Devenda/Cuby_Hardware/Assembly/Side.step

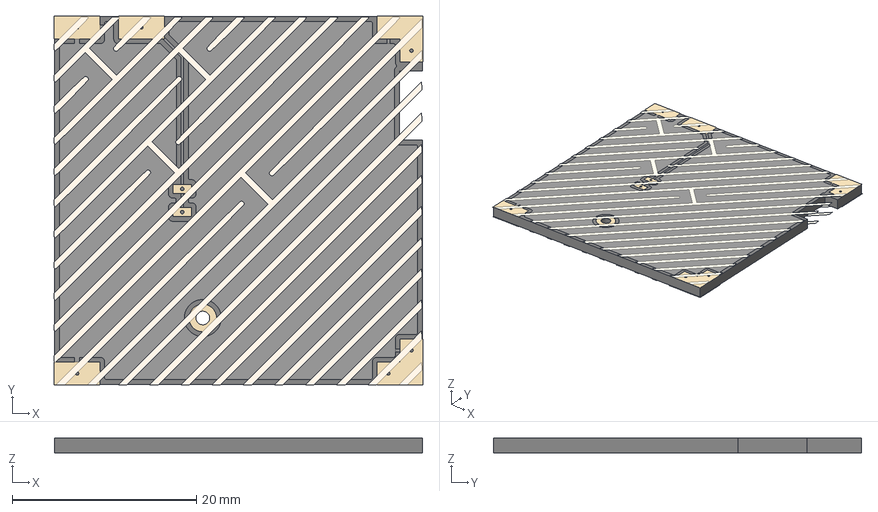
[picture p1: CAD file, 2019-10-11]
Assembly/Side.step
40.1 x 40.1 x 1.74 mm
Local_CS
PCB_Sketch
topTracks
botTracks
botSilks
topSilks
Step_Models
