Devenda/Cuby_Hardware/robot/Assembly/Top.step

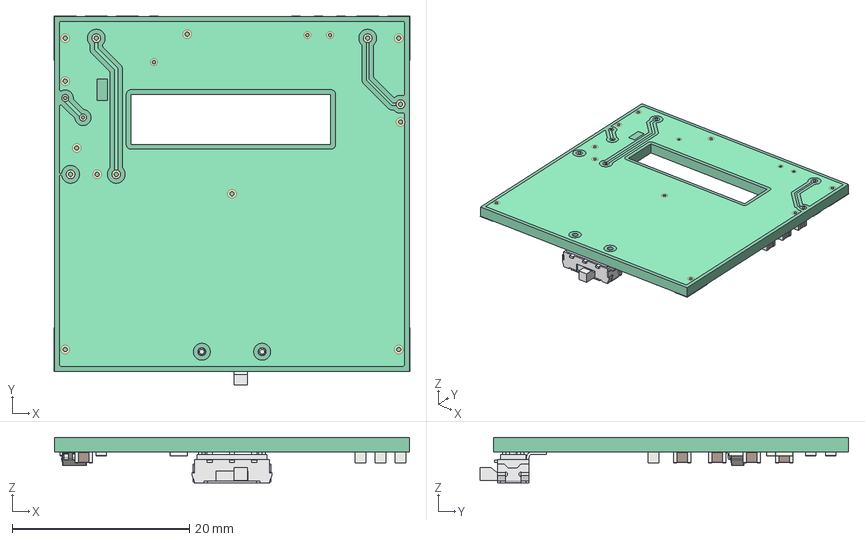
[picture p2: CAD file, 2019-10-03]
robot/Assembly/Top.step
40.1 x 41.6 x 5.15 mm
Local_CS
Pcb
PCB_Sketch
topTracks
botTracks
SW1_1_5D87707B
U2_SOT_23_5_5D8777B4
C2_C_0805_2012Metric_5D94FF89
C3_C_0805_2012Metric_5D94FF99
C4_C_0805_2012Metric_5D94FFA9
C5_C_0805_2012Metric_5D94FFB9
C6_C_0805_2012Metric_5D94FFC9
C7_C_0805_2012Metric_5D950188
R1_R_0805_2012Metric_5D94FFE9
R2_R_0805_2012Metric_5D94FFF9
R3_R_0805_2012Metric_5D950009
R4_R_0805_2012Metric_5D950019
R5_R_0805_2012Metric_5D950029
