Devenda/Cuby_Hardware/Assembly/Back.step

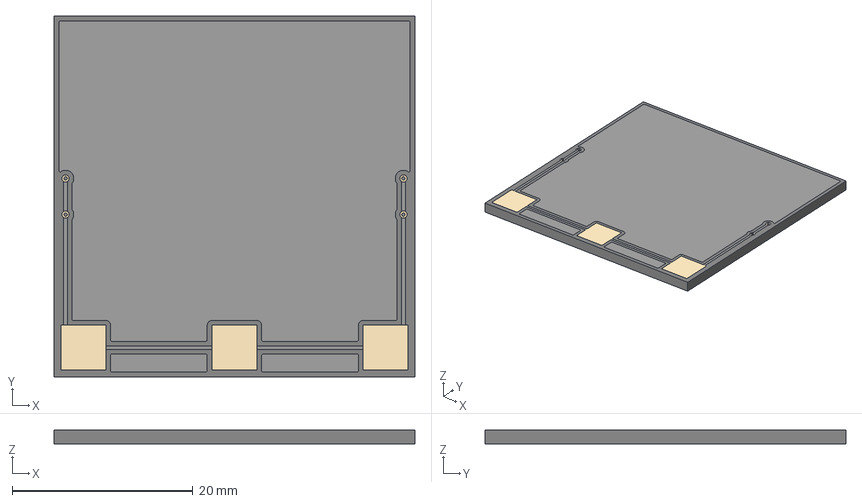
[picture p3: CAD file, 2019-10-11]
Assembly/Back.step
40.0 x 40.0 x 1.70 mm
Local_CS
Pcb
PCB_Sketch
topTracks
botTracks
Step_Models
