Devenda/Cuby_Hardware/(list of files, cad)

Other CAD files:
Back/Gerber/Back-B_SilkS.dxf
Back/Gerber/Back-F_SilkS.dxf
Bottom/Gerber/Bottom-B_SilkS.dxf
Bottom/Gerber/Bottom-F_SilkS.dxf
Front/Gerber/Front-B_SilkS.dxf
Front/Gerber/Front-F_SilkS.dxf
Top/Gerber/Top-B_SilkS.dxf
Top/Gerber/Top-F_SilkS.dxf
