Devenda/Cuby_Hardware/Bottom/Bottom.kicad_pcb

## KiCad design Bottom/Bottom.kicad_pcb (2019-12-20)

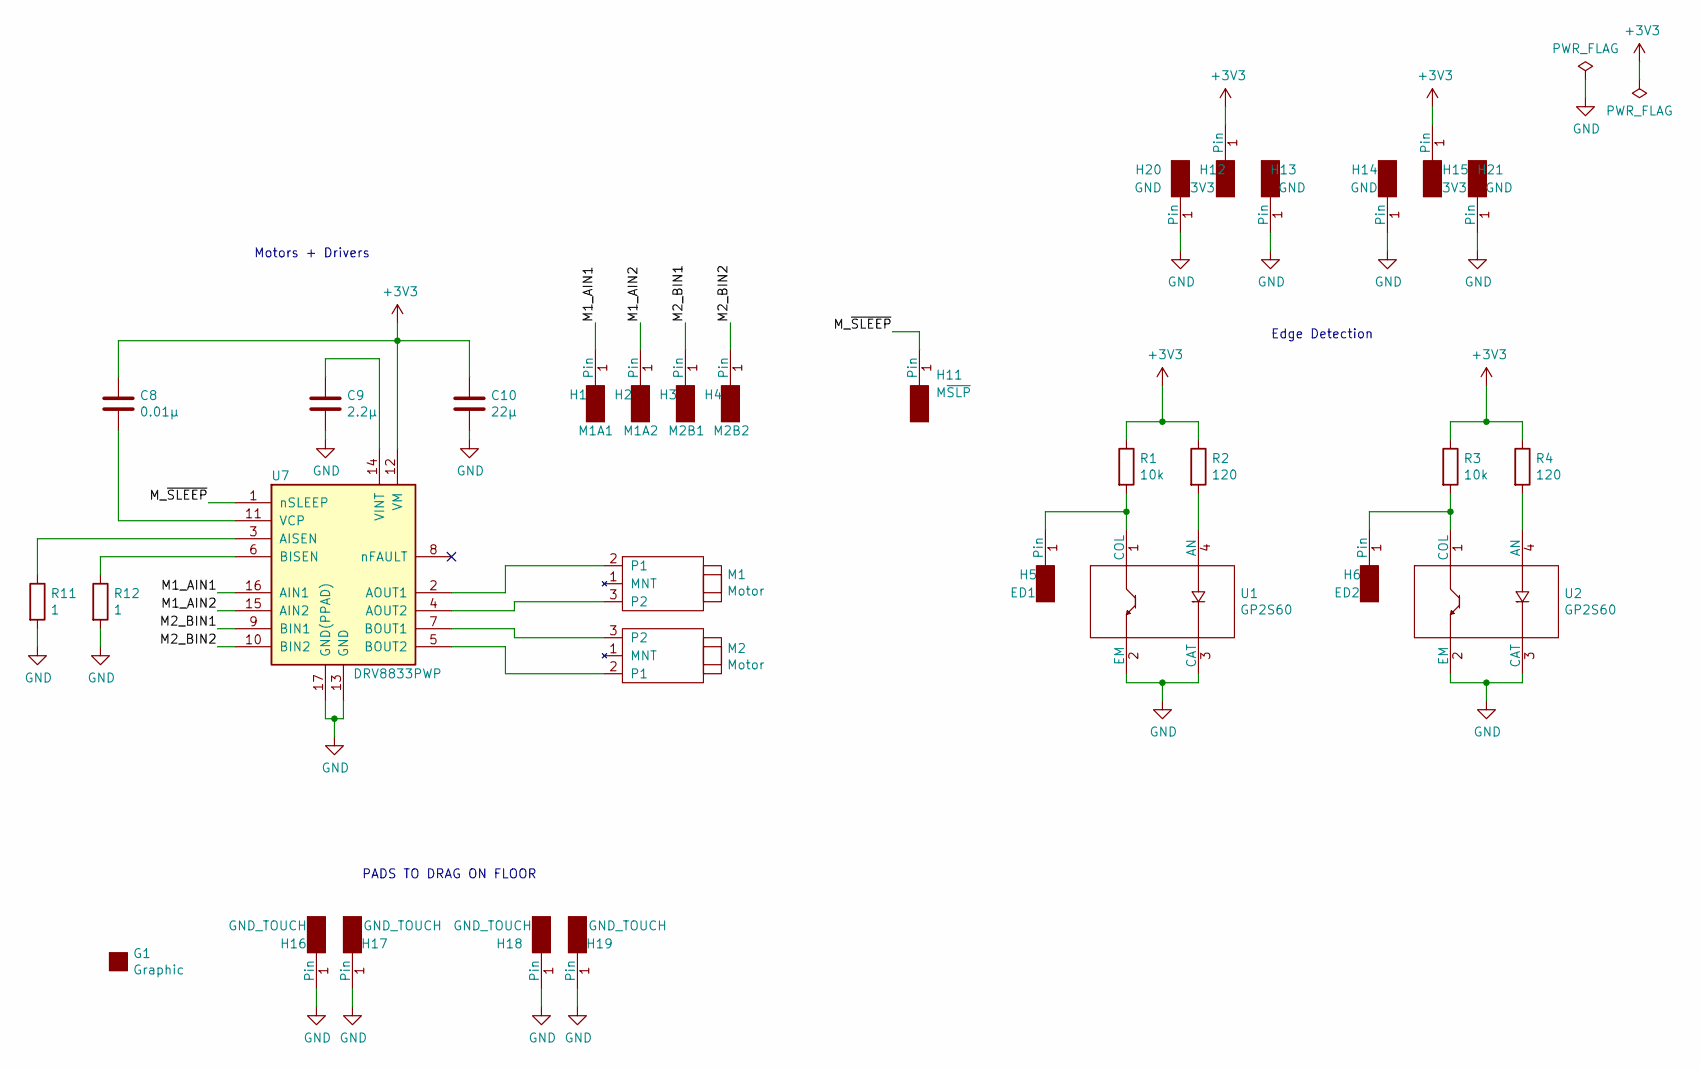
[picture p4: schematic Bottom.sch, Motor and Edge detection]

Parts:
C8: 0.01µ; C_0805_2012Metric; LCSC C52278
C9: 2.2µ; C_0805_2012Metric; LCSC C107171
C10: 22µ; C_0805_2012Metric; LCSC C5674
G1: Graphic; d2
H1: M1A1; Mounting_Pad_Signal
H2: M1A2; Mounting_Pad_Signal
H3: M2B1; Mounting_Pad_Signal
H4: M2B2; Mounting_Pad_Signal
H5: ED1; Mounting_Pad_Signal
H6: ED2; Mounting_Pad_Signal
H11: M~SLP; Mounting_Pad_Signal
H12, H15: 3V3; Mounting_Pad_Power
H13, H14, H20, H21: GND; Mounting_Pad_Power
H16, H17, H18, H19: GND_TOUCH; Mounting_Pad_Ground
M1, M2: Motor; Small_DC_Motor
R1, R3: 10k; R_0805_2012Metric; LCSC C38522
R2, R4: 120; R_0805_2012Metric; LCSC C25281
R11, R12: 1; R_0805_2012Metric; LCSC C25288
U1, U2: GP2S60; GP2S60_ReverseMount; LCSC C83485
U7: DRV8833PWP; HTSSOP-16-1EP_4.4x5mm_P0.65mm_EP3.4x5mm_Mask2.46x2.31mm_The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; Farnell 2057085RL

Connections:
+3V3: C8.1, C10.1, H12.1, H15.1, R1.1, R2.1, R3.1, R4.1, U7.12 (VM)
/M1_AIN1: H1.1, U7.16 (AIN1)
/M1_AIN2: H2.1, U7.15 (AIN2)
/M2_BIN1: H3.1, U7.9 (BIN1)
/M2_BIN2: H4.1, U7.10 (BIN2)
/M_~SLEEP: H11.1, U7.1 (nSLEEP)
GND: C9.2, C10.2, H13.1, H14.1, H16.1, H17.1, H18.1, H19.1, H20.1, H21.1, R11.2, R12.2, U1.2 (EM), U1.3 (CAT), U2.2 (EM), U2.3 (CAT), U7.13 (GND), U7.17 (GND(PPAD))
unnamed: C8.2, U7.11 (VCP)
unnamed: C9.1, U7.14 (VINT)
unnamed: H5.1, R1.2, U1.1 (COL)
unnamed: H6.1, R3.2, U2.1 (COL)
unnamed: M1.2 (P1), U7.2 (AOUT1)
unnamed: M1.3 (P2), U7.4 (AOUT2)
unnamed: M2.2 (P1), U7.5 (BOUT2)
unnamed: M2.3 (P2), U7.7 (BOUT1)
unnamed: R2.2, U1.4 (AN)
unnamed: R4.2, U2.4 (AN)
unnamed: R11.1, U7.3 (AISEN)
unnamed: R12.1, U7.6 (BISEN)

Notes on the sheet:
Motors + Drivers
Edge Detection
PADS TO DRAG ON FLOOR

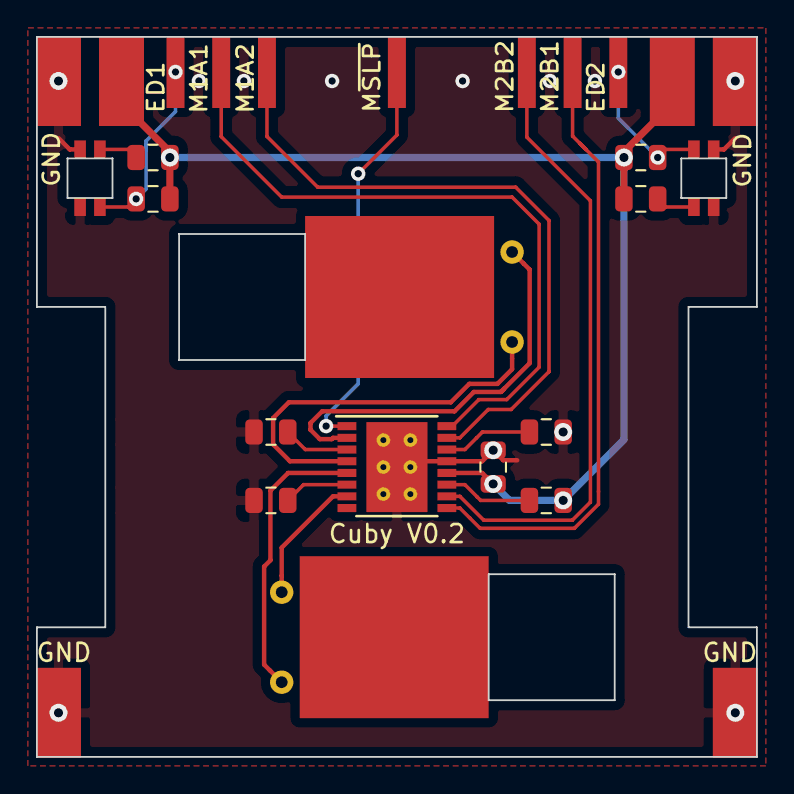
[picture p5: board Bottom.kicad_pcb from above]

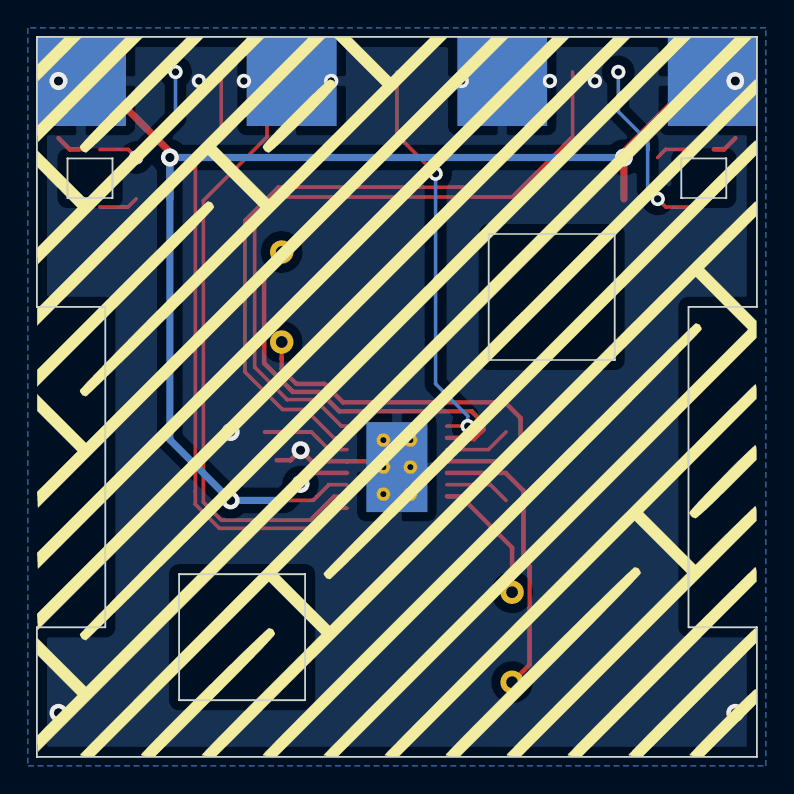
[picture p6: board Bottom.kicad_pcb from below]

Board: 2 copper layers, 40.0 x 40.0 mm, 32 parts (5 on the bottom side), 19 nets.
