Devenda/Cuby_Hardware/Front/Front.kicad_pcb

## KiCad design Front/Front.kicad_pcb (2019-12-20)

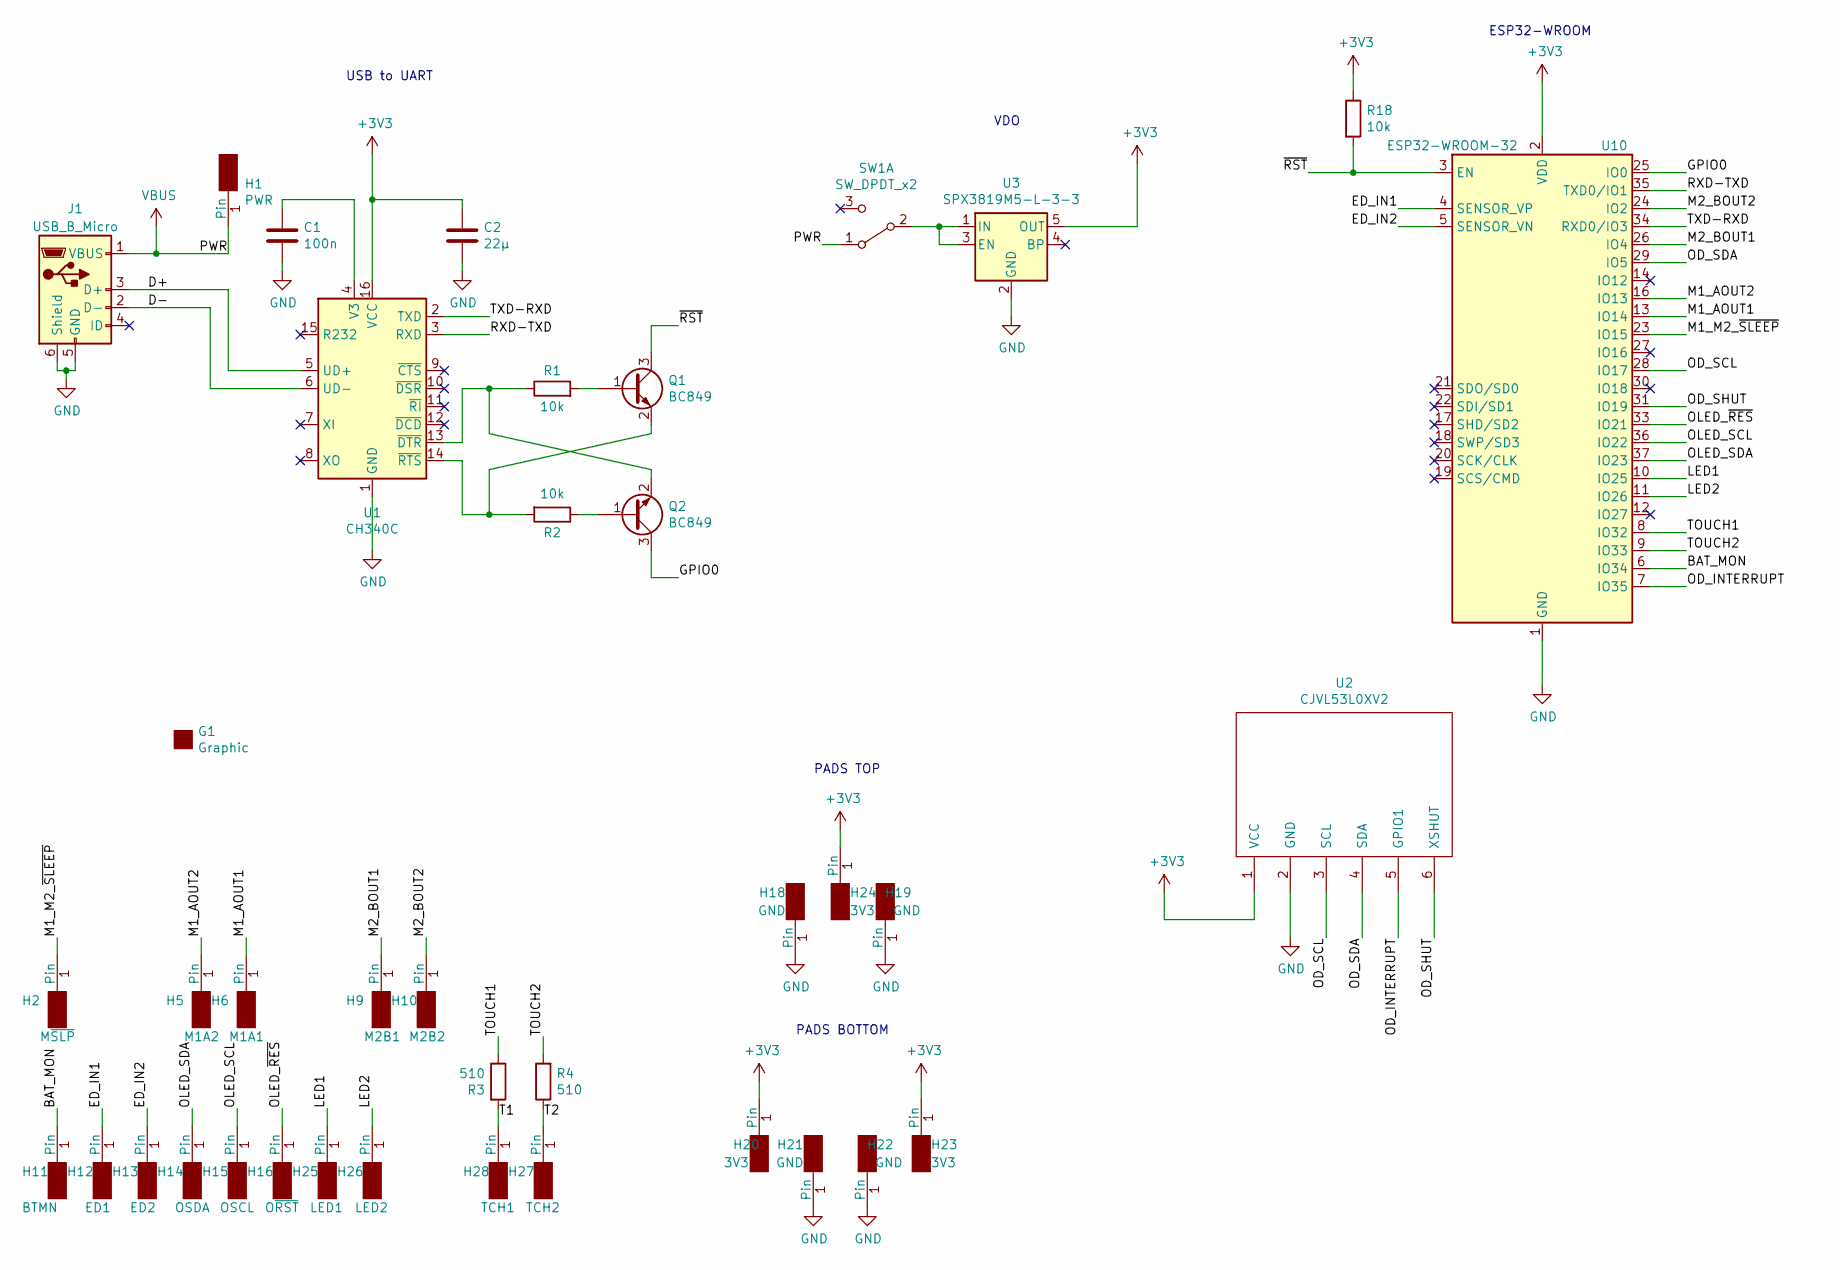
[picture p7: schematic Front.sch, Core]

Parts:
C1: 100n; C_0805_2012Metric; LCSC C282732
C2: 22µ; C_0805_2012Metric; LCSC C5674
G1: Graphic; d1
H1: PWR; Mounting_Pad_Power
H2: M~SLP; Mounting_Pad_Signal
H5: M1A2; Mounting_Pad_Signal
H6: M1A1; Mounting_Pad_Signal
H9: M2B1; Mounting_Pad_Signal
H10: M2B2; Mounting_Pad_Signal
H11: BTMN; Mounting_Pad_Signal
H12: ED1; Mounting_Pad_Signal
H13: ED2; Mounting_Pad_Signal
H14: OSDA; Mounting_Pad_Signal
H15: OSCL; Mounting_Pad_Signal
H16: O~RST; Mounting_Pad_Signal
H18, H19, H21, H22: GND; Mounting_Pad_Power
H20, H23, H24: 3V3; Mounting_Pad_Power
H25: LED1; Mounting_Pad_Signal
H26: LED2; Mounting_Pad_Signal
H27: TCH2; Mounting_Pad_Touch
H28: TCH1; Mounting_Pad_Touch
J1: USB_B_Micro; USB_Micro-B_Molex_47346-0001; LCSC C40942
Q1, Q2: BC849; SOT-23; LCSC C163753
R1, R2, R18: 10k; R_0805_2012Metric; LCSC C38522
R3, R4: 510; R_0805_2012Metric; LCSC C25283
SW1: SW_DPDT_x2; JS102011SAQN
U1: CH340C; SOIC-16_3.9x9.9mm_P1.27mm; LCSC C84681
U2: CJVL53L0XV2; GYVL53L0X_NoMountingHoles
U3: SPX3819M5-L-3-3; SOT-23-5; LCSC C9055
U10: ESP32-WROOM-32

Connections:
+3V3: C2.1, H20.1, H23.1, H24.1, R18.1, U1.16 (VCC), U2.1 (VCC), U3.5 (OUT), U10.2 (VDD)
/BAT_MON: H11.1, U10.6 (IO34)
/D+: J1.3 (D+), U1.5 (UD+)
/D-: J1.2 (D-), U1.6 (UD-)
/ED_IN1: H12.1, U10.4 (SENSOR_VP)
/ED_IN2: H13.1, U10.5 (SENSOR_VN)
/GPIO0: Q2.3 (C), U10.25 (IO0)
/LED1: H25.1, U10.10 (IO25)
/LED2: H26.1, U10.11 (IO26)
/M1_AOUT1: H6.1, U10.13 (IO14)
/M1_AOUT2: H5.1, U10.16 (IO13)
/M1_M2_~SLEEP: H2.1, U10.23 (IO15)
/M2_BOUT1: H9.1, U10.26 (IO4)
/M2_BOUT2: H10.1, U10.24 (IO2)
/OD_INTERRUPT: U2.5 (GPIO1), U10.7 (IO35)
/OD_SCL: U2.3 (SCL), U10.28 (IO17)
/OD_SDA: U2.4 (SDA), U10.29 (IO5)
/OD_SHUT: U2.6 (XSHUT), U10.31 (IO19)
/OLED_SCL: H15.1, U10.36 (IO22)
/OLED_SDA: H14.1, U10.37 (IO23)
/OLED_~RES: H16.1, U10.33 (IO21)
/RXD-TXD: U1.3 (RXD), U10.35 (TXD0/IO1)
/T1: H28.1, R3.2
/T2: H27.1, R4.1
/TOUCH1: R3.1, U10.8 (IO32)
/TOUCH2: R4.2, U10.9 (IO33)
/TXD-RXD: U1.2 (TXD), U10.34 (RXD0/IO3)
/~RST: Q1.3 (C), R18.2, U10.3 (EN)
GND: C1.2, C2.2, H18.1, H19.1, H21.1, H22.1, J1.5 (GND), J1.6 (Shield), U1.1 (GND), U2.2 (GND), U3.2 (GND), U10.1 (GND), U10.15 (GND), U10.38 (GND)
unnamed: C1.1, U1.4 (V3)
unnamed: Q1.1 (B), R1.2
unnamed: Q1.2 (E), R2.2, U1.14 (~RTS)
unnamed: Q2.1 (B), R2.1
unnamed: Q2.2 (E), R1.1, U1.13 (~DTR)
unnamed: SW1.2 (B), U3.1 (IN), U3.3 (EN)
VBUS: H1.1, J1.1 (VBUS), SW1.1 (A)

Notes on the sheet:
ESP32-WROOM
USB to UART
VDO
PADS BOTTOM
PADS TOP

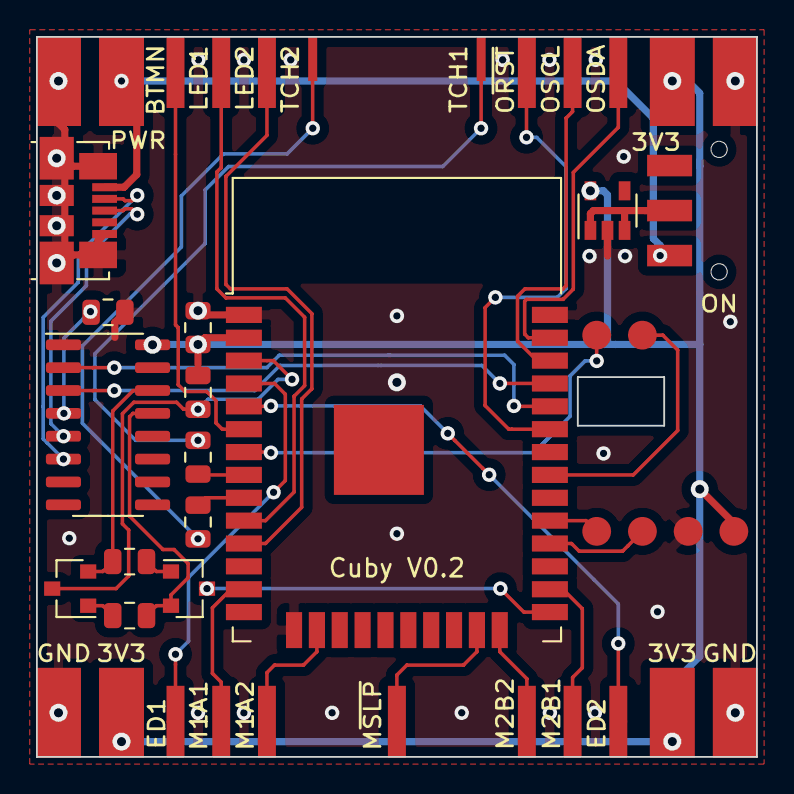
[picture p8: board Front.kicad_pcb from above]

Board: 2 copper layers, 40.0 x 40.0 mm, 39 parts (1 on the bottom side), 36 nets.
