Devenda/Cuby_Hardware/Top/Top.kicad_pcb

## KiCad design Top/Top.kicad_pcb (2019-12-04)

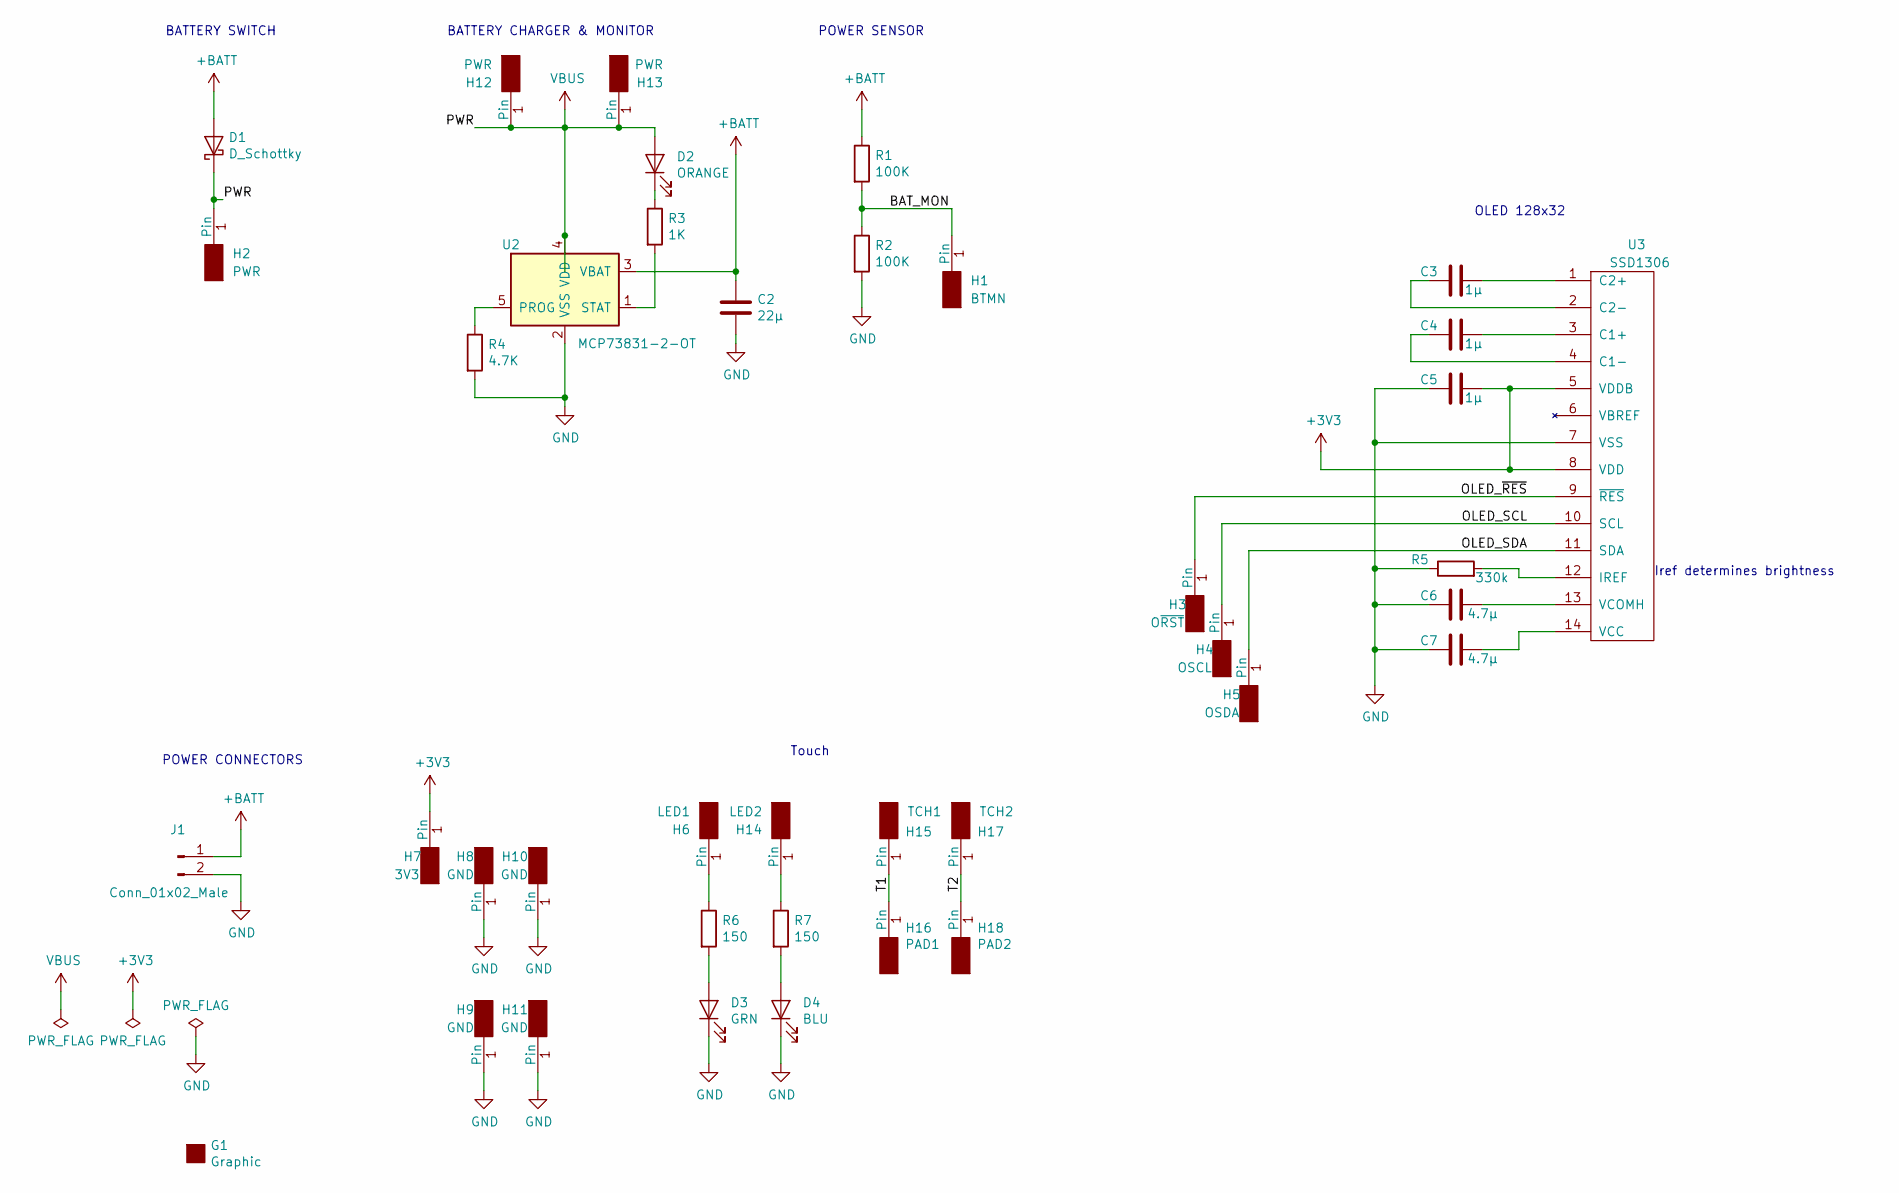
[picture p9: schematic Top.sch, (Top) Power Management + OLED]

Parts:
C2: 22µ; C_0805_2012Metric; LCSC C5674
C3, C4, C5: 1µ; C_0805_2012Metric; LCSC C106837
C6, C7: 4.7µ; C_0805_2012Metric; LCSC C87998
D1: D_Schottky; D_SOD-123; LCSC C181204
D2: ORANGE; LED_0805_2012Metric; LCSC C84269
D3: GRN; LED_0805_2012Metric
D4: BLU; LED_0805_2012Metric
G1: Graphic; d3
H1: BTMN; Mounting_Pad_Signal
H2, H12, H13: PWR; Mounting_Pad_Power
H3: O~RST; Mounting_Pad_Signal
H4: OSCL; Mounting_Pad_Signal
H5: OSDA; Mounting_Pad_Signal
H6: LED1; Mounting_Pad_Signal
H7: 3V3; Mounting_Pad_Power
H8, H9, H10, H11: GND; Mounting_Pad_Power
H14: LED2; Mounting_Pad_Signal
H15: TCH1; Mounting_Pad_Touch
H16: PAD1; Touch_Pad
H17: TCH2; Mounting_Pad_Touch
H18: PAD2; Touch_Pad
J1: Conn_01x02_Male; Conn_Bat
R1, R2: 100K; R_0805_2012Metric; LCSC C25611
R3: 1K; R_0805_2012Metric; LCSC C25623
R4: 4.7K; R_0805_2012Metric; LCSC C26022
R5: 330k; R_0805_2012Metric; LCSC C17629
R6, R7: 150; R_0805_2012Metric; LCSC C26022
U2: MCP73831-2-OT; SOT-23-5; LCSC C14879
U3: SSD1306; SSD1306_OLED

Connections:
+3V3: C5.1, H7.1, U3.5 (VDDB), U3.8 (VDD)
+BATT: C2.1, D1.2 (A), J1.1, R1.1, U2.3 (VBAT)
/BAT_MON: H1.1, R1.2, R2.1
/OLED_SCL: H4.1, U3.10 (SCL)
/OLED_SDA: H5.1, U3.11 (SDA)
/OLED_~RES: H3.1, U3.9 (~RES)
/T1: H15.1, H16.1
/T2: H17.1, H18.1
GND: C2.2, C5.2, C6.2, C7.1, D3.1 (K), D4.1 (K), H8.1, H9.1, H10.1, H11.1, J1.2, R2.2, R4.2, R5.1, U2.2 (VSS), U3.7 (VSS)
unnamed: C3.1, U3.1 (C2+)
unnamed: C3.2, U3.2 (C2-)
unnamed: C4.1, U3.3 (C1+)
unnamed: C4.2, U3.4 (C1-)
unnamed: C6.1, U3.13 (VCOMH)
unnamed: C7.2, U3.14 (VCC)
unnamed: D2.1 (K), R3.1
unnamed: D3.2 (A), R6.2
unnamed: D4.2 (A), R7.2
unnamed: H6.1, R6.1
unnamed: H14.1, R7.1
unnamed: R3.2, U2.1 (STAT)
unnamed: R4.1, U2.5 (PROG)
unnamed: R5.2, U3.12 (IREF)
VBUS: D1.1 (K), D2.2 (A), H2.1, H12.1, H13.1, U2.4 (VDD)

Notes on the sheet:
BATTERY CHARGER & MONITOR
POWER SENSOR
POWER CONNECTORS
OLED 128x32
Iref determines brightness
BATTERY SWITCH
Touch

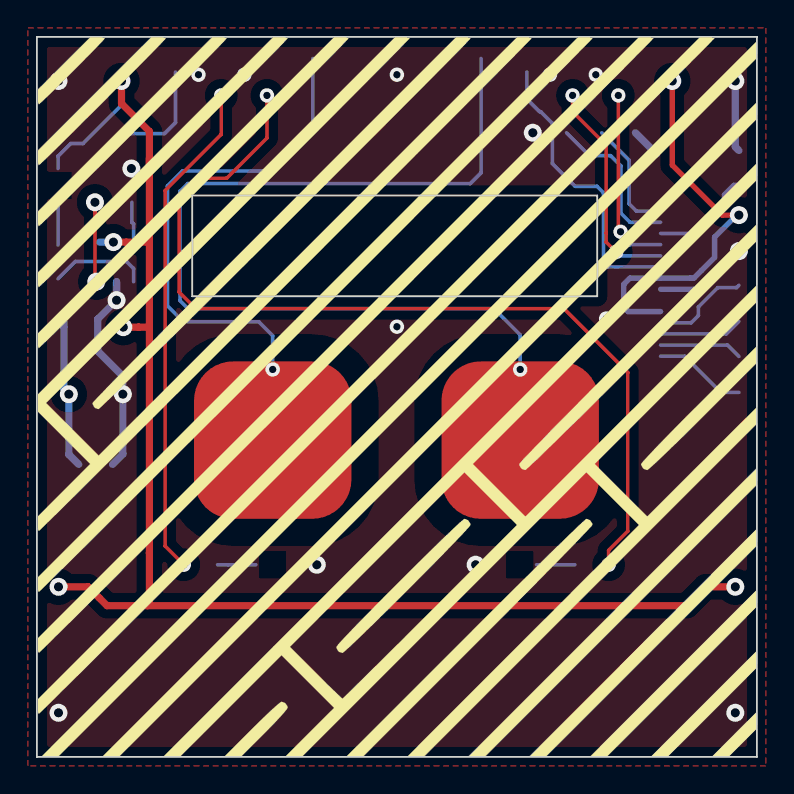
[picture p10: board Top.kicad_pcb from above]

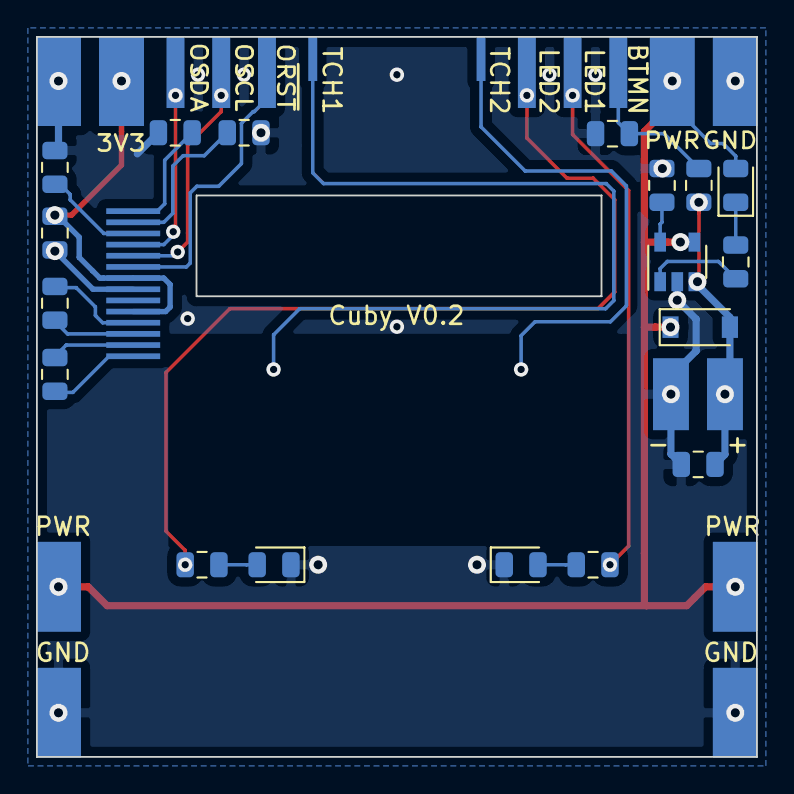
[picture p11: board Top.kicad_pcb from below]

Board: 2 copper layers, 40.0 x 40.0 mm, 39 parts (36 on the bottom side), 24 nets.
