Devenda/Cuby_Hardware/Side Left/SideLeft.kicad_pcb

## KiCad design Side Left/SideLeft.kicad_pcb (2019-10-11)

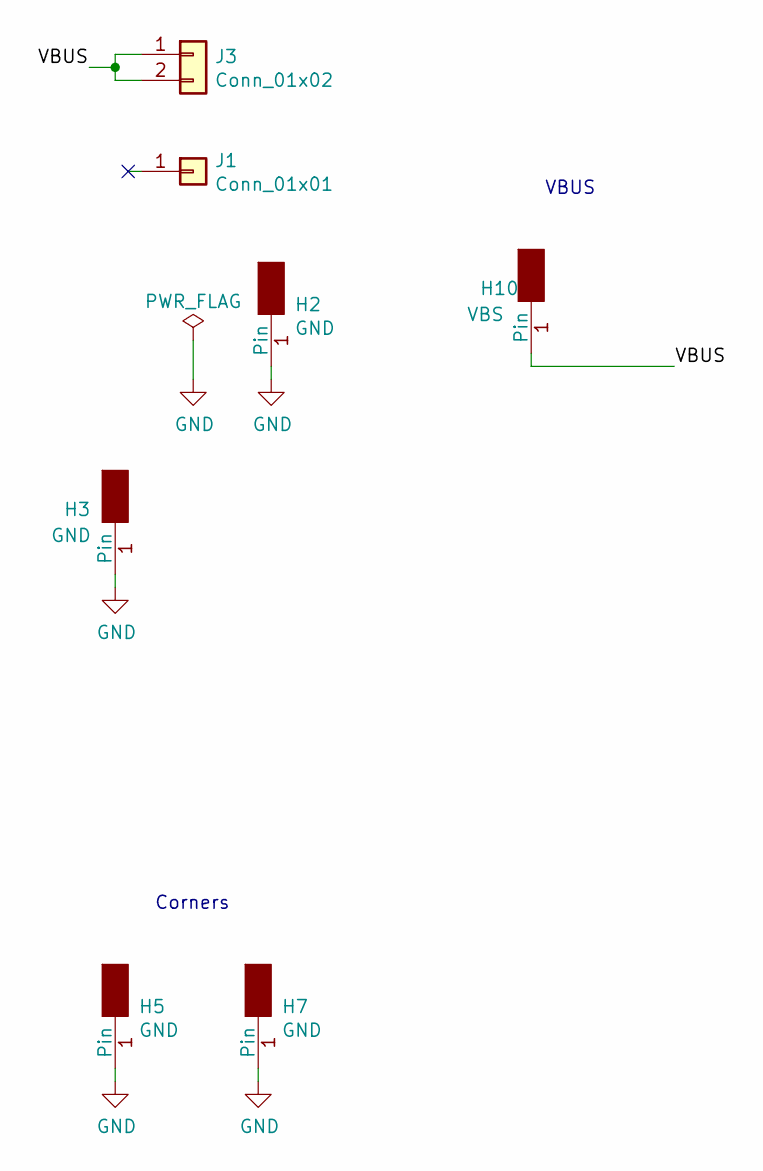
[picture p12: schematic SideLeft.sch, Side]

Parts:
H2, H3: GND; Mounting_Pad_Power
H5, H7: GND; Mounting_Pad_Power_Corner
H10: VBS; Mounting_Pad_Power
J1: Conn_01x01; Axis
J3: Conn_01x02; BG300-02-A-L-A

Connections:
/VBUS: H10.1, J3.1, J3.2
GND: H2.1, H3.1, H5.1, H7.1

Notes on the sheet:
Corners
VBUS

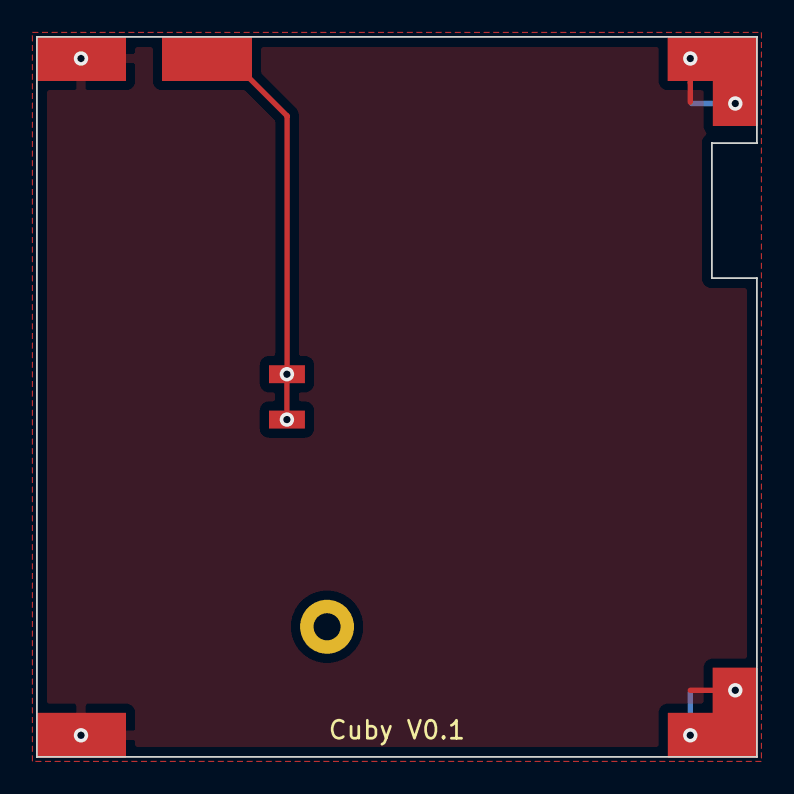
[picture p13: board SideLeft.kicad_pcb from above]

Board: 2 copper layers, 40.0 x 40.0 mm, 7 parts (0 on the bottom side), 2 nets.
