Devenda/Cuby_Hardware/Side Right/SideRight.kicad_pcb

## KiCad design Side Right/SideRight.kicad_pcb (2019-10-11)

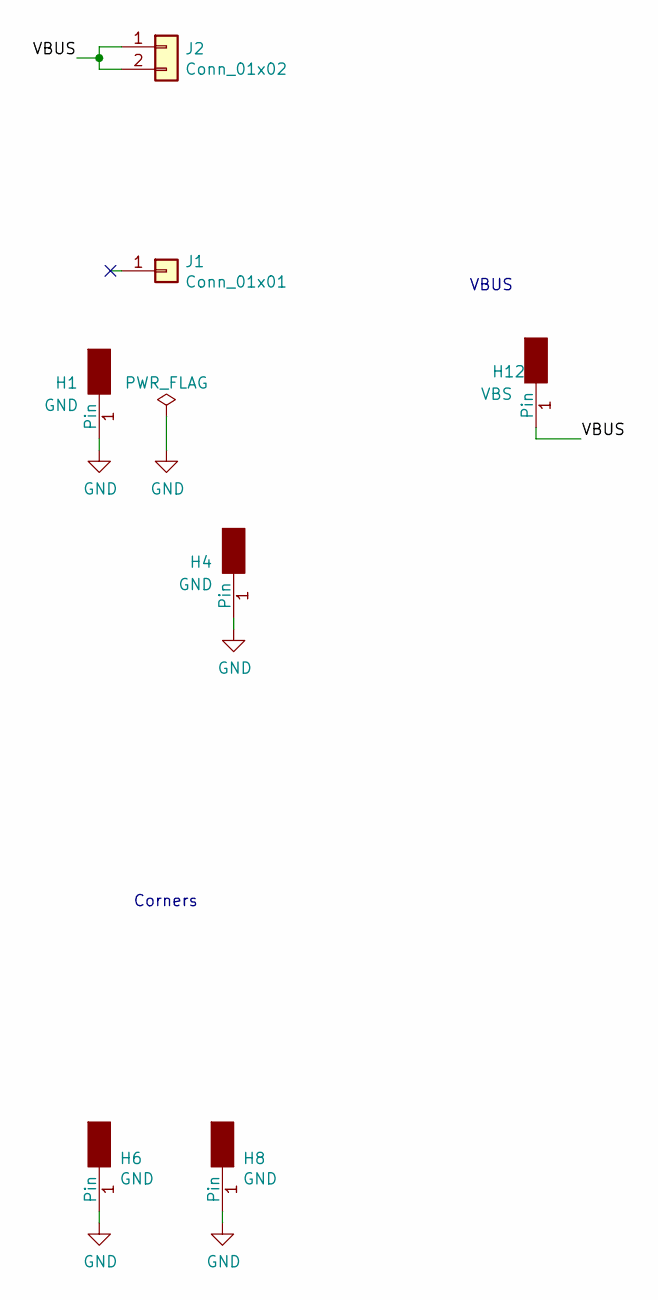
[picture p14: schematic SideRight.sch, Side]

Parts:
H1, H4: GND; Mounting_Pad_Power
H6, H8: GND; Mounting_Pad_Power_Corner
H12: VBS; Mounting_Pad_Power
J1: Conn_01x01; Axis
J2: Conn_01x02; BG300-02-A-L-A

Connections:
/VBUS: H12.1, J2.1, J2.2
GND: H1.1, H4.1, H6.1, H8.1

Notes on the sheet:
Corners
VBUS

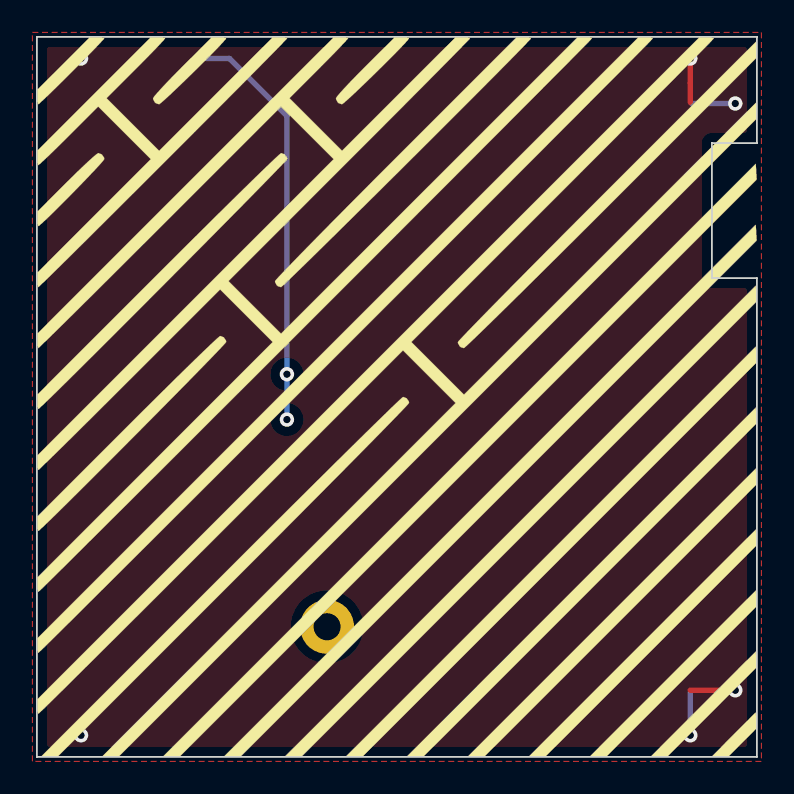
[picture p15: board SideRight.kicad_pcb from above]

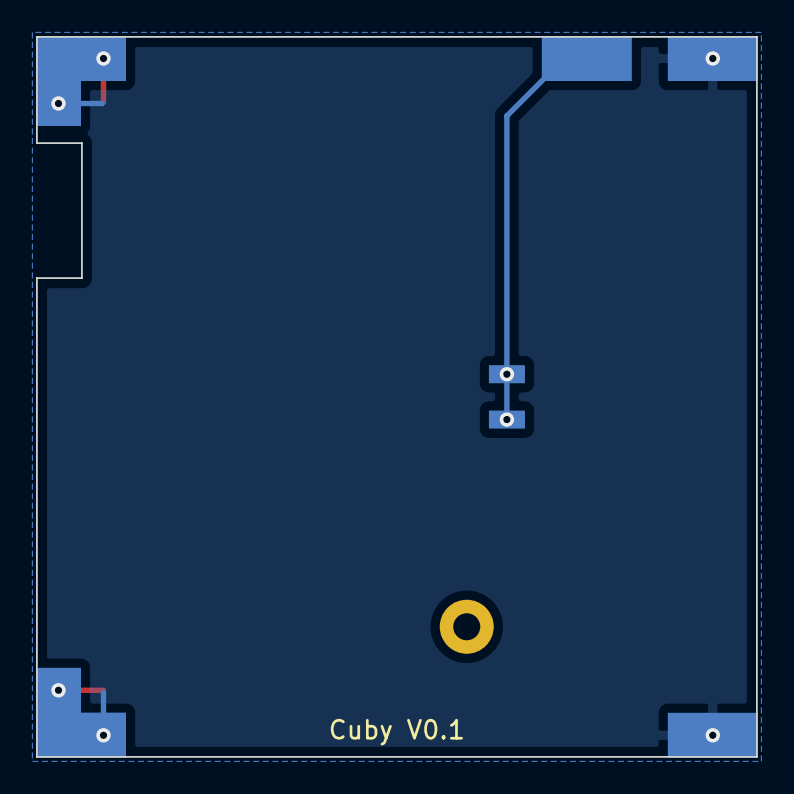
[picture p16: board SideRight.kicad_pcb from below]

Board: 2 copper layers, 40.0 x 40.0 mm, 7 parts (6 on the bottom side), 2 nets.
