Devenda/Cuby_Hardware/(commit log)

2019-06-28 Added Project base
    [robot.kicad_pcb, robot.sch]
2019-06-30 Power management
    [Core.sch, PowerManagement.sch, USBToUART.sch]
2019-07-02 USB to UART + autoreset
    [USBToUART.sch, robot.sch]
2019-07-16 added new core, changes to USBToUART
    [Core.sch, USBToUART.sch]
2019-08-25 Object detection, reset
    [Core.sch, Object Detection.sch, PowerManagement.sch, USBToUART.sch, robot.sch]
2019-08-25 Edge Detection, start Motor and Driver
    [Core.sch, Edge Detection.sch, Motor And Driver.sch, Object Detection.sch, PowerManagement.sch, USBToUART.sch, robot.sch]
2019-08-30 Motor driver
    [Core.sch, Edge Detection.sch, Motor And Driver.sch, Object Detection.sch, PowerManagement.sch, USBToUART.sch, robot.sch]
2019-08-30 UI parts, (re)wiring remaining signals
    [Core.sch, Edge Detection.sch, Motor And Driver.sch, Object Detection.sch, PowerManagement.sch, UI.sch, USBToUART.sch, robot.sch]
2019-09-01 DRC check fixes and small changes
    [Core.sch, Edge Detection.sch, Motor And Driver.sch, Object Detection.sch, PowerManagement.sch, UI.sch, USBToUART.sch]
2019-09-01 Testpoints, switch, small changes
    [Core.sch, Edge Detection.sch, Motor And Driver.sch, Object Detection.sch, PowerManagement.sch, UI.sch, USBToUART.sch]
2019-09-02 annotations, testpoints, small changes
    [PowerManagement.sch]
2019-09-06 Restructure project
    Removed sub sheets and made 'sub' project all in the same folder
    [Bottom.sch, Core.sch, Edge Detection.sch, Front.kicad_pcb, Front.sch, Motor And Driver.sch, Object Detection.sch, PowerManagement.sch]
2019-09-08 Cleanup, start PDB Front
    [Bottom.sch, Front.kicad_pcb, Front.sch, Top.sch]
2019-09-10 Front PCB
    [Front.kicad_pcb, Front.sch]
2019-09-11 Front Routing
    [Front.kicad_pcb, Front.sch]
2019-09-12 Finish Front
    [Front.kicad_pcb]
2019-09-13 Top PCB
    [Top.kicad_pcb, Top.sch]
2019-09-13 Swap 3V3 and VBUS, Fix Cutout, small changes
    [Front.kicad_pcb, Top.kicad_pcb]
2019-09-13 Silkscreen Top
    [Top.kicad_pcb]
2019-09-16 Start renumber
    [Bottom.kicad_pcb, Bottom.sch]
2019-09-16 Renumber and more Bottom
    [Bottom.kicad_pcb, Front.kicad_pcb, Front.sch]
2019-09-18 Finish bottom
    [Bottom.kicad_pcb, Bottom.sch]
2019-09-19 Bottem changes
    [Bottom.kicad_pcb, Bottom.sch]
2019-09-21 Shrink design
    [Front.kicad_pcb, Front.sch]
2019-09-22 Finish Front redesign
    [Front.kicad_pcb, Front.sch]
2019-09-22 Finish Top, remap OLED pins
    [Front.kicad_pcb, Front.sch, Top.kicad_pcb, Top.sch]
2019-09-22 Finisch bottom
    [Bottom.kicad_pcb, Bottom.sch]
2019-09-25 Changes to bottom, 3D export
    [Bottom.kicad_pcb]
2019-09-26 Small fixes, step files
    [Bottom.kicad_pcb, Front.kicad_pcb, Top.kicad_pcb, Top.step]
2019-09-26 Small changes to top, step
    [Top.kicad_pcb]
2019-09-27 Move Motors
    [Bottom.kicad_pcb]
2019-09-29 Layout changes, new footprints, added Side PCB
    [Front.kicad_pcb, Side.kicad_pcb, Side.sch, Side.step, Top.kicad_pcb]
2019-10-02 Changes to structure
    [Bottom.kicad_pcb, Bottom.sch, Front.kicad_pcb]
2019-10-02 Top changes
    [Bottom.sch, Top.kicad_pcb]
2019-10-02 Update footprints
    [Top.kicad_pcb]
2019-10-03 Small changes, connectors
    [Bottom.kicad_pcb, Bottom.sch, Front.kicad_pcb, Side.kicad_pcb, Side.sch, Side.step, Top.kicad_pcb, Top.sch]
2019-10-06 Add VBS, Add Silk deco, small changes
    [Bottom-B_SilkS.dxf, Bottom-F_SilkS.dxf, Bottom.kicad_pcb, Front-B_SilkS.dxf, Front-F_SilkS.dxf, Front.kicad_pcb, Side-B_SilkS.dxf, Side-F_SilkS.dxf]
2019-10-11 Small changes, BOM, Gerbers
    [Back-B_SilkS.dxf, Back-F_SilkS.dxf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]
2019-10-11 BOM items
    [Bottom.kicad_pcb, Bottom.sch, Front.sch, Top.kicad_pcb, Top.sch]
2019-11-18 Changes to motor on bottom: fix mirrored pins
    [Bottom-B_SilkS.dxf, Bottom-F_SilkS.dxf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]
2019-11-23 V0.2: Redo front schematic and PCB
    [Front.kicad_pcb, Front.sch, Top.sch]
2019-11-30 updated bottom (motor placement, sharp sensor), front redesign, start op top redesign
    [Bottom.kicad_pcb, Front.kicad_pcb, Top.kicad_pcb, Top.sch]
2019-12-02 Update Top V0.2, small changes to motor placement
    [Bottom-B_SilkS.dxf, Bottom-F_SilkS.dxf, Bottom.kicad_pcb, Front.kicad_pcb, Top.kicad_pcb, Top.sch]
2019-12-03 finish top, changes to front, added graphic
    [Bottom-B_SilkS.dxf, Bottom-F_SilkS.dxf, Bottom.kicad_pcb, Bottom.sch, Front-B_SilkS.dxf, Front-F_SilkS.dxf, Front.kicad_pcb, Front.sch]
2019-12-04 finishing touches, moved touch traces to back
    [Front.kicad_pcb, Top-B_SilkS.dxf, Top.kicad_pcb]
2019-12-17 Small DC motor
2019-12-18 Bottom, new motor, positioning and start routing
    [Bottom.kicad_pcb, Bottom.sch]
2019-12-20 removed extra pins in front, respaced pins in bottom and front
    [Bottom.kicad_pcb, Front.kicad_pcb, Front.sch]
